p-sampson-II/elephant/KiCad/Elephant0.9.2/Elephant0.9.2.ods

# | Reference | Qty | Value | Footprint | Digikey Part
1 | BT1 | 1 | 9v Battery | Connector_JST:JST_PH_B2B-PH-K_1x02_P2.00mm_Vertical | https://www.digikey.com/en/products/detail/keystone-electronics/232/303804
2 | BT2 | 1 | Coin Cell | Battery:BatteryHolder_Keystone_1057_1x2032 | https://www.digikey.com/en/products/detail/keystone-electronics/1057TR/4692903
3 | C1, C2, C4, C14 | 4 | 1uF | Capacitor_SMD:C_0603_1608Metric | https://www.digikey.com/en/products/detail/samsung-electro-mechanics/CL10A105KA8NNNC/3886760
4 | C3 | 1 | 100u | Library:Capacitor SMD 2917 (7343 Metric) | https://www.digikey.com/en/products/detail/kyocera-avx/TCJY107M016R0050/5001463
5 | C5, C6, C7, C11 | 4 | 470pF | Capacitor_SMD:C_0201_0603Metric | https://www.digikey.com/en/products/detail/murata-electronics/GRM033R71C471KA01D/2543516
6 | C8, C9 | 2 | 2pF | Capacitor_SMD:C_0201_0603Metric | https://www.digikey.com/en/products/detail/murata-electronics/GRM0335C1H2R0BA01D/4358709
7 | C10 | 1 | 4.7uF,<1Ω | paul:1411 (3528 Metric) | https://www.digikey.com/en/products/detail/vishay-sprague/TR3B475K035C0700/2259924
8 | C12, C13 | 2 | 4pF | Capacitor_SMD:C_0201_0603Metric | https://www.digikey.com/en/products/detail/murata-electronics/GRM0335C1E4R0CA01D/4358231
9 | C15 | 1 | 10nF | Capacitor_SMD:C_0201_0603Metric | https://www.digikey.com/en/products/detail/murata-electronics/GRM033R71A103KA01D/702460
10 | C16, C18 | 2 | 100nF | Capacitor_SMD:C_0201_0603Metric | https://www.digikey.com/en/products/detail/murata-electronics/GRM033R61A104ME15D/2175191
11 | C17 | 1 | 4.7uF | Capacitor_SMD:C_0603_1608Metric | https://www.digikey.com/en/products/detail/samsung-electro-mechanics/CL10A475KP8NNNC/3886702
12 | D3 | 1 | LED | LED_SMD:LED_0603_1608Metric | https://www.digikey.com/en/products/detail/creeled-inc/XQEGRN-H2-0000-000000B01/5423124
13 | FB1, FB2, FB3, FB4 | 4 | FerriteBead_Small | Inductor_SMD:L_0402_1005Metric | https://www.digikey.com/en/products/detail/laird-signal-integrity-products/MI0402K121R-10/4765745
14 | H1, H2, H3, H4 | 4 | MountingHole | MountingHole:MountingHole_2.7mm_M2.5 | N/A
15 | J1 | 1 | Conn_01x04_Pin | Connector_JST:JST_PH_B4B-PH-K_1x04_P2.00mm_Vertical | N/A
16 | J2 | 1 | Conn_01x05_Pin | Connector_JST:JST_PH_B5B-PH-K_1x05_P2.00mm_Vertical | N/A
17 | L1 | 1 | 2.2uH | Inductor_SMD:L_Bourns-SRN8040_8x8.15mm | https://www.digikey.com/en/products/detail/bourns-inc/SRN8040-2R2Y/2756130
18 | LS1, LS2 | 2 | Speaker | Connector_JST:JST_PH_B2B-PH-K_1x02_P2.00mm_Vertical | https://www.digikey.com/en/products/detail/pui-audio-inc/AS04008CO-WR-R/1745536
19 | R1 | 1 | 10k | Resistor_SMD:R_0603_1608Metric | https://www.digikey.com/en/products/detail/yageo/RC0603FR-0710KL/726880
20 | R2 | 1 | 500Ω | paul:TC42 – 2 mm SMD Trimpot - Bournes | https://www.digikey.com/en/products/detail/bourns-inc/TC42X-2-501E/3722204
21 | R4 | 1 | 2.4kΩ | Resistor_SMD:R_0603_1608Metric | https://www.digikey.com/en/products/detail/yageo/RC0603FR-072K4L/727023
22 | R7 | 1 | 330 Ω | Resistor_SMD:R_0603_1608Metric | https://www.digikey.com/en/products/detail/yageo/RC0603JR-07330RL/726769
23 | R8 | 1 | 17.8k | Resistor_SMD:R_0603_1608Metric | https://www.digikey.com/en/products/detail/yageo/RC0603FR-0717K8L/726983
24 | SW1 | 1 | SW_TILT | Connector_PinHeader_2.54mm:PinHeader_1x02_P2.54mm_Vertical | N/A
25 | TP1 | 1 | 3v3 | TestPoint:TestPoint_Pad_D1.0mm | N/A
26 | TP2 | 1 | GND | TestPoint:TestPoint_Pad_D1.0mm | N/A
27 | U1 | 1 | LT8640 | paul:LT8640 | https://www.digikey.com/en/products/detail/analog-devices-inc/LT8640AJUDCM-3-3-PBF/17952220
28 | U3 | 1 | SSM2518 | Package_DFN_QFN:QFN-20-1EP_4x4mm_P0.5mm_EP2.5x2.5mm | https://www.digikey.com/en/products/detail/analog-devices-inc/SSM2518CPZ-R7/3043350
29 | U4 | 1 | M95M04 | Package_SO:TSSOP-8_4.4x3mm_P0.65mm | https://www.digikey.com/en/products/detail/stmicroelectronics/M95M04-DRDW6TP/11482497
30 | U5 | 1 | STM32F401CCUx | Package_DFN_QFN:QFN-48-1EP_7x7mm_P0.5mm_EP5.6x5.6mm | https://www.digikey.com/en/products/detail/stmicroelectronics/STM32F401CCU6/4755971
31 | Y1 | 1 | 32.768kHz, 6pF, 50kΩ | Crystal:Crystal_SMD_Abracon_ABS25-4Pin_8.0x3.8mm | https://www.digikey.com/en/products/detail/ecs-inc/ECS-327-6-17X-C-TR/5875555
32 | Y2 | 1 | 16MHz, 7pF, 60Ω | Crystal:Crystal_SMD_3225-4Pin_3.2x2.5mm | https://www.digikey.com/en/products/detail/ecs-inc/ECS-160-7-33B2-CKM-TR3/18108759
