p-sampson-II/elephant/FreeCad/Enclosure.FCStd

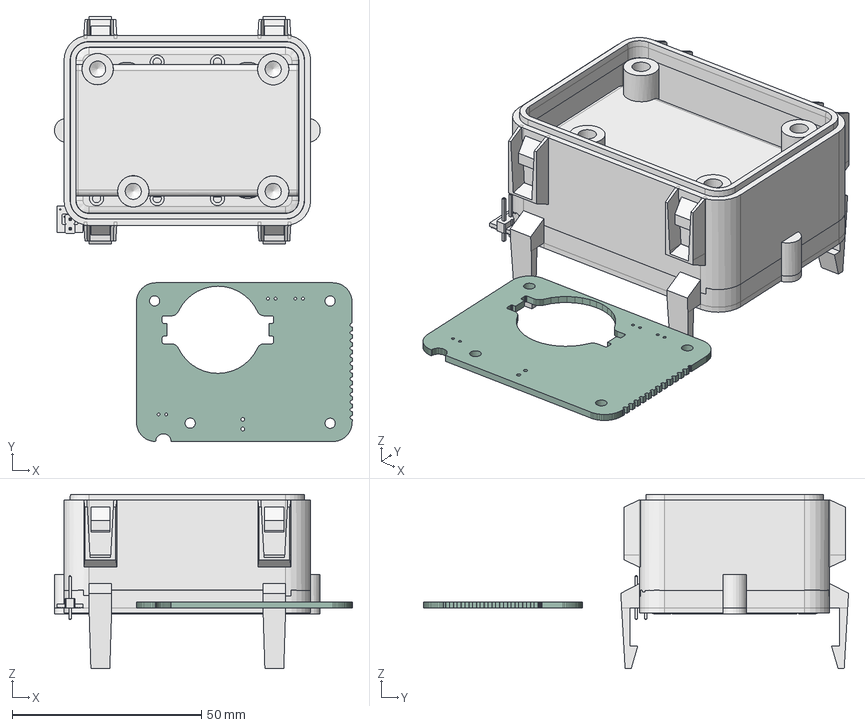
[picture p1: CAD file, 2024-02-07]
FreeCad/Enclosure.FCStd
78.6 x 112.2 x 46.0 mm
batterydoor
C_0201_0603Metric
C_0201_0603Metric002
C_0201_0603Metric004
QFN-20-1EP_4x4mm_Pitch0.5mm
L_0402_1005Metric
C_0603_1608Metric
L_0402_1005Metric002
C_0603_1608Metric002
C_0201_0603Metric006
PinHeader_1x02_P254mm_Vertical
R_0603_1608Metric
C_0603_1608Metric004
TSSOP_8_44x3mm_P065mm
C_0201_0603Metric008
Crystal_SMD_3225-4Pin_3.2x2.5mm
QFN_48_1EP_7x7mm_P05mm_EP56x56mm
C_0201_0603Metric010
C_0201_0603Metric012
C_0201_0603Metric014
C_0201_0603Metric016
LED_0603_1608Metric
R_0603_1608Metric002
R_0603_1608Metric004
C_0603_1608Metric006
R_0603_1608Metric006
C_0201_0603Metric018
C_0201_0603Metric020
L_0402_1005Metric004
C_0603_1608Metric008
L_0402_1005Metric006
