p-sampson-II/elephant/KiCad/Elephant0.9.2/Elephant0.9.2.kicad_pcb

## KiCad design KiCad/Elephant0.9.2/Elephant0.9.2.kicad_pcb (2024-02-07)

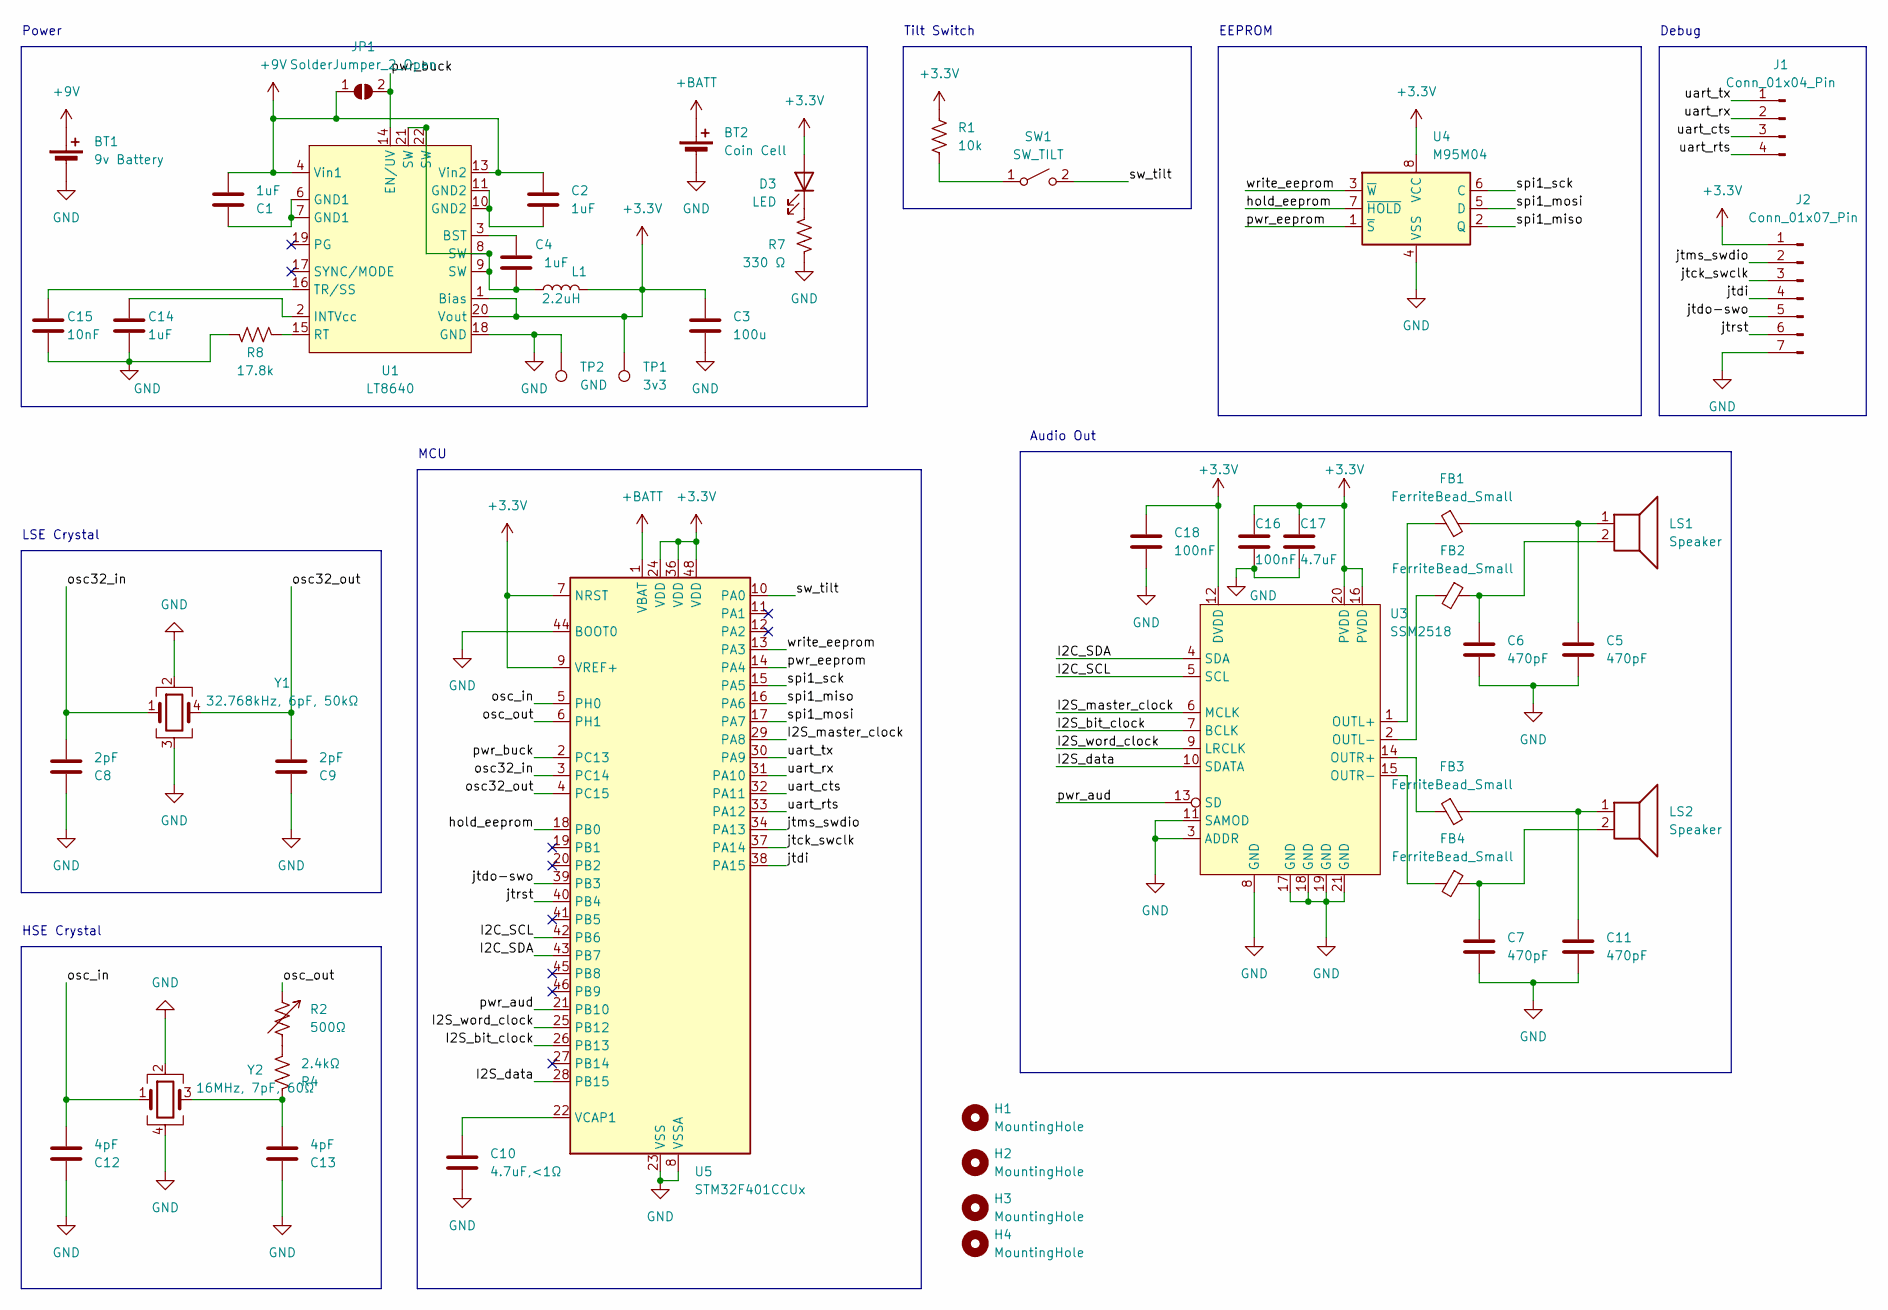
[picture p2: schematic Elephant0.9.2.kicad_sch]

Parts:
BT1: 9v Battery; JST_PH_B2B-PH-K_1x02_P2.00mm_Vertical
BT2: Coin Cell; BatteryHolder_Keystone_1057_1x2032
C1, C2, C4, C14: 1uF; C_0603_1608Metric
C3: 100u; Capacitor SMD 2917 (7343 Metric)
C5, C6, C7, C11: 470pF; C_0603_1608Metric
C8, C9: 2pF; C_0603_1608Metric
C10: 4.7uF,<1Ω; 1411 (3528 Metric)
C12, C13: 4pF; C_0603_1608Metric
C15: 10nF; C_0603_1608Metric
C16, C18: 100nF; C_0603_1608Metric
C17: 4.7uF; C_0603_1608Metric
D3: LED; LED_0603_1608Metric
FB1, FB2, FB3, FB4: FerriteBead_Small; L_0402_1005Metric
H1, H2, H3, H4: MountingHole; MountingHole_2.7mm_M2.5
J1: Conn_01x04_Pin; JST_PH_B4B-PH-K_1x04_P2.00mm_Vertical
J2: Conn_01x07_Pin; JST_PH_B7B-PH-K_1x07_P2.00mm_Vertical
JP1: SolderJumper_2_Open; SolderJumper-2_P1.3mm_Open_Pad1.0x1.5mm
L1: 2.2uH; L_Bourns-SRN8040_8x8.15mm
LS1, LS2: Speaker; JST_PH_B2B-PH-K_1x02_P2.00mm_Vertical
R1: 10k; R_0603_1608Metric
R2: 500Ω; TC42 – 2 mm SMD Trimpot - Bournes
R4: 2.4kΩ; R_0603_1608Metric
R7: 330 Ω; R_0603_1608Metric
R8: 17.8k; R_0603_1608Metric
SW1: SW_TILT; PinHeader_1x02_P2.54mm_Vertical
TP1: 3v3; TestPoint_Pad_D1.0mm
TP2: GND; TestPoint_Pad_D1.0mm
U1: LT8640
U3: SSM2518; QFN-20-1EP_4x4mm_P0.5mm_EP2.5x2.5mm
U4: M95M04; TSSOP-8_4.4x3mm_P0.65mm
U5: STM32F401CCUx; QFN-48-1EP_7x7mm_P0.5mm_EP5.6x5.6mm
Y1: 32.768kHz, 6pF, 50kΩ; Crystal_SMD_Abracon_ABS25-4Pin_8.0x3.8mm
Y2: 16MHz, 7pF, 60Ω; Crystal_SMD_3225-4Pin_3.2x2.5mm

Connections:
+3.3V: C3.1, C16.1, C17.1, C18.1, D3.2 (A), J2.1, L1.2, R1.1, TP1.1, U1.1 (Bias), U1.20 (Vout), U3.12 (DVDD), U3.16 (PVDD), U3.20 (PVDD), U4.8 (VCC), U5.7 (NRST), U5.9 (VREF+), U5.24 (VDD), U5.36 (VDD), U5.48 (VDD)
+9V: BT1.1 (+), C1.2, C2.1, JP1.1 (A), U1.4 (Vin1), U1.13 (Vin2)
+BATT: BT2.1 (+), U5.1 (VBAT)
/I2C_SCL: U3.5 (SCL), U5.42 (PB6)
/I2C_SDA: U3.4 (SDA), U5.43 (PB7)
/I2S_bit_clock: U3.7 (BCLK), U5.26 (PB13)
/I2S_data: U3.10 (SDATA), U5.28 (PB15)
/I2S_master_clock: U3.6 (MCLK), U5.29 (PA8)
/I2S_word_clock: U3.9 (LRCLK), U5.25 (PB12)
/hold_eeprom: U4.7 (~HOLD), U5.18 (PB0)
/jtck_swclk: J2.3, U5.37 (PA14)
/jtdi: J2.4, U5.38 (PA15)
/jtdo-swo: J2.5, U5.39 (PB3)
/jtms_swdio: J2.2, U5.34 (PA13)
/jtrst: J2.6, U5.40 (PB4)
/osc32_in: C8.2, U5.3 (PC14), Y1.1
/osc32_out: C9.2, U5.4 (PC15), Y1.4
/osc_in: C12.2, U5.5 (PH0), Y2.1
/osc_out: R2.1, U5.6 (PH1)
/pwr_aud: U3.13 (SD), U5.21 (PB10)
/pwr_buck: JP1.2 (B), U1.14 (EN/UV), U5.2 (PC13)
/pwr_eeprom: U4.1 (~S), U5.14 (PA4)
/spi1_miso: U4.2 (Q), U5.16 (PA6)
/spi1_mosi: U4.5 (D), U5.17 (PA7)
/spi1_sck: U4.6 (C), U5.15 (PA5)
/sw_tilt: SW1.2 (B), U5.10 (PA0)
/uart_cts: J1.3, U5.32 (PA11)
/uart_rts: J1.4, U5.33 (PA12)
/uart_rx: J1.2, U5.31 (PA10)
/uart_tx: J1.1, U5.30 (PA9)
/write_eeprom: U4.3 (~W), U5.13 (PA3)
GND: BT1.2 (-), BT2.2 (-), C3.2, C5.2, C6.2, C7.2, C8.1, C9.1, C10.2, C11.2, C12.1, C13.1, C14.2, C15.2, C16.2, C17.2, C18.2, J2.7, R7.2, R8.2, TP2.1, U1.18 (GND), U3.3 (ADDR), U3.8 (GND), U3.11 (SAMOD), U3.17 (GND), U3.18 (GND), U3.19 (GND), U3.21 (GND), U4.4 (VSS), U5.8 (VSSA), U5.23 (VSS), U5.35 (VSS), U5.44 (BOOT0), U5.47 (VSS), U5.49 (VSS), Y1.2, Y1.3, Y2.2, Y2.4
unnamed: C1.1, U1.6 (GND1), U1.7 (GND1)
unnamed: C2.2, U1.10 (GND2), U1.11 (GND2)
unnamed: C4.2, L1.1, U1.8 (SW), U1.9 (SW), U1.21 (SW), U1.22 (SW)
unnamed: C5.1, FB1.2, LS1.1
unnamed: C6.1, FB2.1, LS1.2
unnamed: C7.1, FB4.1, LS2.2
unnamed: C11.1, FB3.2, LS2.1
unnamed: C13.2, R4.1, Y2.3
unnamed: D3.1 (K), R7.1
unnamed: R2.2, R4.2
unnamed: R1.2, SW1.1 (A)
unnamed: C4.1, U1.3 (BST)
unnamed: C14.1, U1.2 (INTVcc)
unnamed: R8.1, U1.15 (RT)
unnamed: C15.1, U1.16 (TR/SS)
unnamed: FB1.1, U3.1 (OUTL+)
unnamed: FB2.2, U3.2 (OUTL-)
unnamed: FB3.1, U3.14 (OUTR+)
unnamed: FB4.2, U3.15 (OUTR-)
unnamed: C10.1, U5.22 (VCAP1)

Notes on the sheet:
HSE Crystal
MCU
Power
Debug
Audio Out
EEPROM
Tilt Switch
LSE Crystal

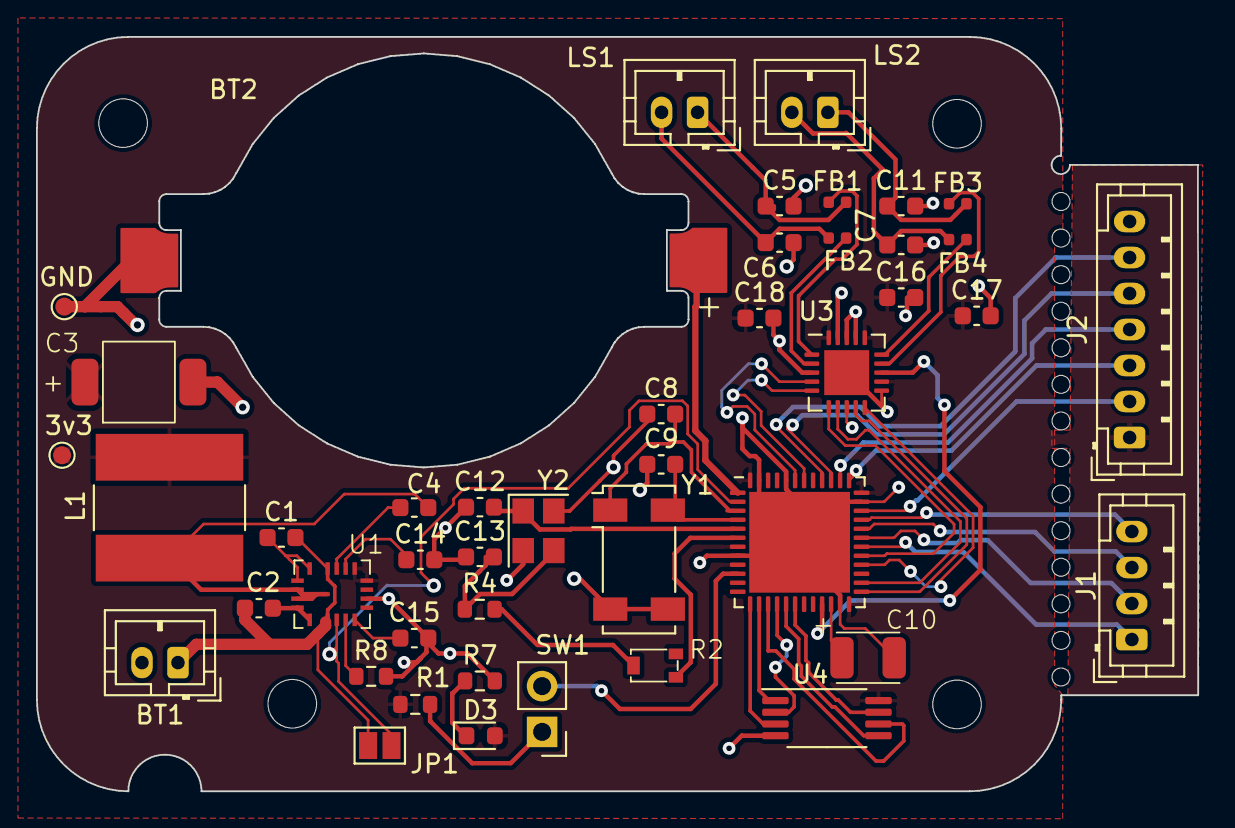
[picture p3: board Elephant0.9.2.kicad_pcb from above]

Board: 2 copper layers, 64.5 x 41.9 mm, 49 parts (0 on the bottom side), 52 nets.
