p-sampson-II/elephant/Core/Src/main.cpp

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
/* Includes ------------------------------------------------------------------*/

#include "main.h"


/* USER CODE BEGIN Includes */
#include "audio_test.h"
/* USER CODE END Includes */

/* USER CODE BEGIN PD */
const int n_interrupts = 1;
const int spi_txcplt_irqn = 0;
/* USER CODE END PD */

I2C_HandleTypeDef hi2c1;

I2S_HandleTypeDef hi2s2;
DMA_HandleTypeDef hdma_spi2_tx;

RTC_HandleTypeDef hrtc;

SPI_HandleTypeDef hspi1;

UART_HandleTypeDef huart1;

/* USER CODE BEGIN PV */

i2sObject i2sObj(hi2s2);

static InterruptHandler *Handlers[n_interrupts];

/* USER CODE END PV */

void SystemClock_Config(void);
static void MX_GPIO_Init(void);
static void MX_DMA_Init(void);
static void MX_I2C1_Init(void);
static void MX_I2S2_Init(void);
static void MX_SPI1_Init(void);
static void MX_USART1_UART_Init(void);
static void MX_RTC_Init(void);
void register_handler(int irq_n, InterruptHandler* handler);
/**
  * @brief  The application entry point.
  * @retval int
  */
int main(void)
{
  /* MCU Configuration--------------------------------------------------------*/

  /* Reset of all peripherals, Initializes the Flash interface and the Systick. */
  HAL_Init();

  /* Configure the system clock */
  SystemClock_Config();

  /* Initialize all configured peripherals */
  MX_GPIO_Init();
  MX_DMA_Init();
  MX_I2C1_Init();
  MX_I2S2_Init();
  MX_SPI1_Init();
  MX_USART1_UART_Init();
  MX_RTC_Init();
  /* USER CODE BEGIN 2 */
  register_handler(spi_txcplt_irqn, &i2sObj);
  audio_test::runTest(hi2c1, hdma_spi2_tx, i2sObj);
  /* USER CODE END 2 */

  /* Infinite loop */
  /* USER CODE BEGIN WHILE */
  while (1)
  {
    /* USER CODE END WHILE */

    /* USER CODE BEGIN 3 */
  }
  /* USER CODE END 3 */
}

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
/* USER CODE BEGIN 4 */

extern "C" void HAL_I2S_TxCpltCallback(I2S_HandleTypeDef *hi2s) {
    Handlers[spi_txcplt_irqn]->irq();
}

void register_handler(int irq_n, InterruptHandler* handler) {
    Handlers[irq_n] = handler;
}

/* USER CODE END 4 */
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
