p-sampson-II/elephant/ElephantR9.ioc

Mcu.UserName=STM32F401CCUx
PA0-WKUP.GPIO_Label=sw_tilt
PA0-WKUP.Signal=SYS_WKUP
PA1.GPIO_Label=ld_heartbeat
PA1.Signal=GPIO_Output
PA10.Signal=USART1_RX
PA11.Signal=USART1_CTS
PA12.Signal=USART1_RTS
PA13.Signal=SYS_JTMS-SWDIO
PA14.Signal=SYS_JTCK-SWCLK
PA15.Signal=SYS_JTDI
PA3.GPIO_Label=pwr_eeprom
PA3.Signal=GPIO_Output
PA4.GPIO_Label=write_eeprom
PA4.Signal=GPIO_Output
PA5.Signal=SPI1_SCK
PA6.Signal=SPI1_MISO
PA7.Signal=SPI1_MOSI
PA8.Signal=RCC_MCO_1
PA9.Signal=USART1_TX
PB0.GPIO_Label=hold_eeprom
PB0.Signal=GPIO_Output
PB10.GPIO_Label=pwr_aud
PB10.Signal=GPIO_Output
PB12.Signal=I2S2_WS
PB13.Signal=I2S2_CK
PB15.Signal=I2S2_SD
PB3.Signal=SYS_JTDO-SWO
PB4.Signal=SYS_JTRST
PB6.Signal=I2C1_SCL
PB7.Signal=I2C1_SDA
PC13-ANTI_TAMP.Signal=RTC_AF1
PC14-OSC32_IN.Signal=RCC_OSC32_IN
PC15-OSC32_OUT.Signal=RCC_OSC32_OUT
