p-sampson-II/elephant/Core/Inc/main.h

#define sw_tilt_Pin GPIO_PIN_0
#define sw_tilt_GPIO_Port GPIOA
#define ld_heartbeat_Pin GPIO_PIN_1
#define ld_heartbeat_GPIO_Port GPIOA
#define pwr_eeprom_Pin GPIO_PIN_3
#define pwr_eeprom_GPIO_Port GPIOA
#define write_eeprom_Pin GPIO_PIN_4
#define write_eeprom_GPIO_Port GPIOA
#define hold_eeprom_Pin GPIO_PIN_0
#define hold_eeprom_GPIO_Port GPIOB
#define pwr_aud_Pin GPIO_PIN_10
#define pwr_aud_GPIO_Port GPIOB
