p-sampson-II/elephant/(commit log)

2024-01-03 STM32 Files
2024-01-03 KiCad files
    [Elephant0.9.2-B_Cu.gbr, Elephant0.9.2-B_Mask.gbr, Elephant0.9.2-B_Paste.gbr, Elephant0.9.2-B_Silkscreen.gbr, Elephant0.9.2-Edge_Cuts.gbr, Elephant0.9.2-F_Cu.gbr, Elephant0.9.2-F_Mask.gbr, Elephant0.9.2-F_Paste.gbr]
2024-02-07 Added the audio system with a way to test it.
    [Elephant0.9.2.kicad_pcb, Elephant0.9.2.kicad_sch, Enclosure.FCStd]
